Norpz/Baka/robotont-electronics-mainboard-devel-veiko/3dmodels/MR30PW-M v2.step

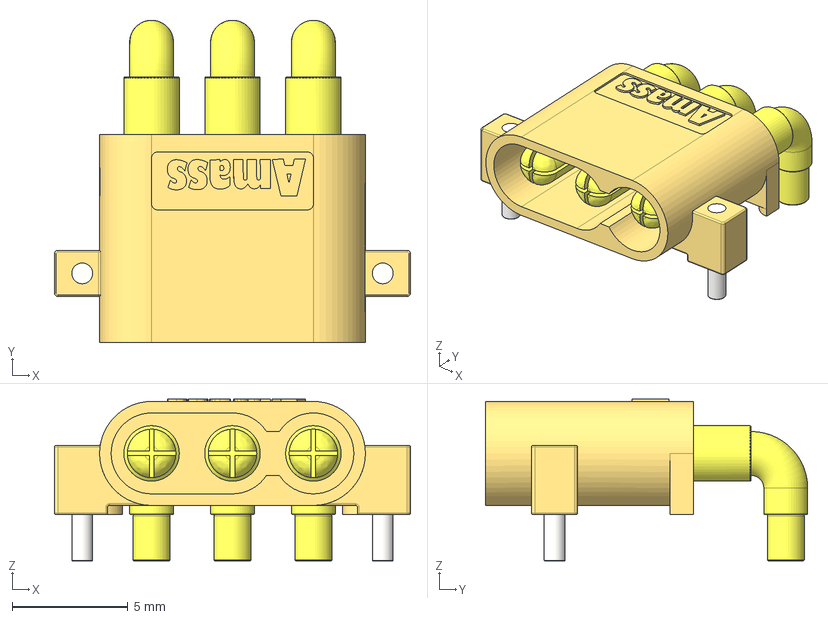
[picture p1: CAD file, 2023-09-22]
robotont-electronics-mainboard-devel-veiko/3dmodels/MR30PW-M v2.step
15.4 x 13.9 x 7.00 mm
PCB Pins
Pin 2 x 3
