Norpz/Baka/robotont-electronics-mainboard-devel-veiko/3dmodels/USB_C_Receptacle_USB2.0.STEP

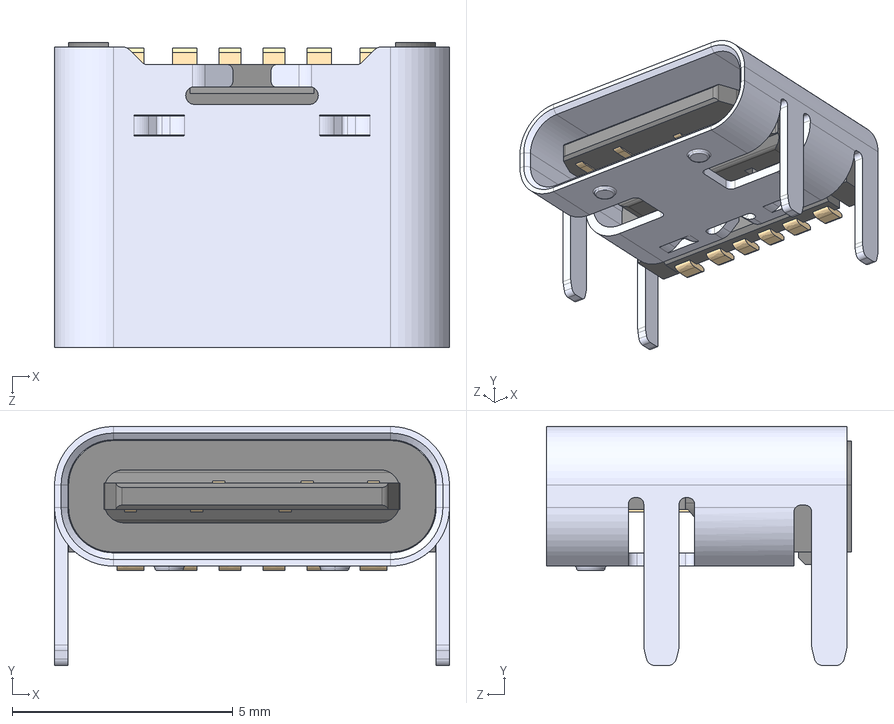
[picture p3: CAD file, 2023-09-22]
robotont-electronics-mainboard-devel-veiko/3dmodels/USB_C_Receptacle_USB2.0.STEP
8.94 x 5.41 x 6.90 mm
