Norpz/Baka/robotont-electronics-mainboard-devel-veiko/3dmodels/IND-FXL1040 v5.step

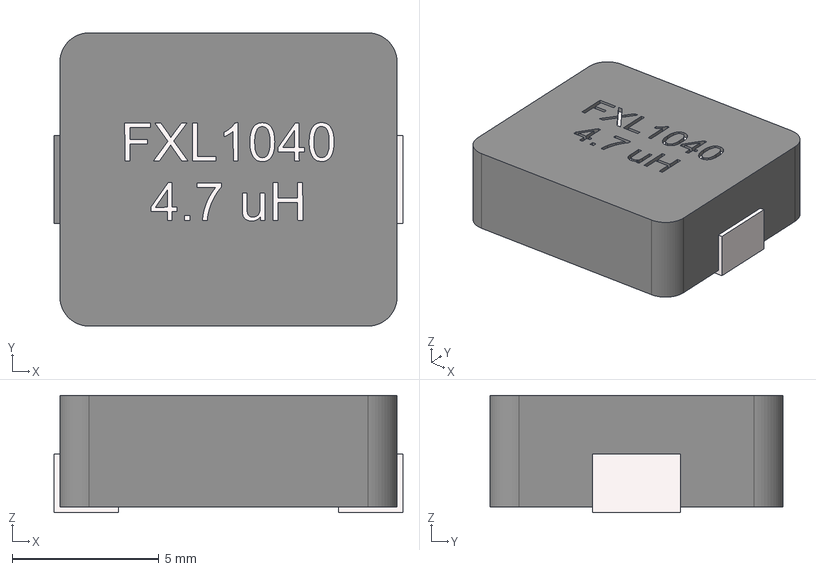
[picture p4: CAD file, 2023-09-22]
robotont-electronics-mainboard-devel-veiko/3dmodels/IND-FXL1040 v5.step
11.9 x 10.0 x 4.00 mm
