Norpz/Baka/robotont-electronics-mainboard-devel-veiko/3dmodels/DIODE-SOD-128.step

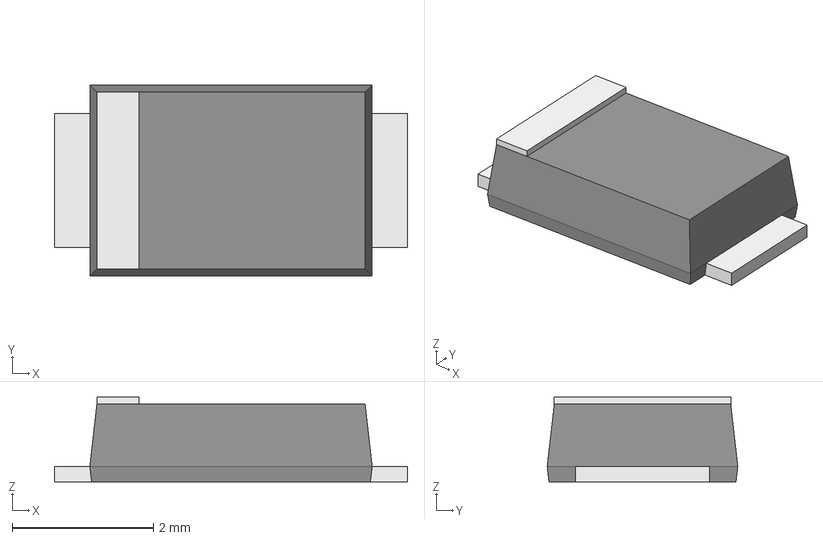
[picture p5: CAD file, 2023-09-22]
robotont-electronics-mainboard-devel-veiko/3dmodels/DIODE-SOD-128.step
5.00 x 2.70 x 1.20 mm
