Norpz/Baka/robotont-electronics-mainboard-devel-veiko/3dmodels/Diode_powerdi5.STEP

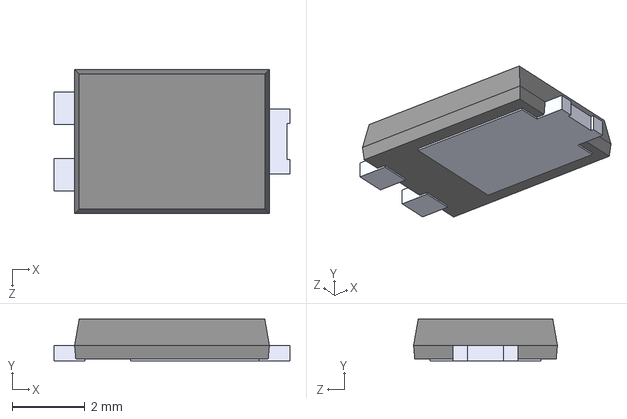
[picture p6: CAD file, 2023-09-22]
robotont-electronics-mainboard-devel-veiko/3dmodels/Diode_powerdi5.STEP
6.50 x 1.15 x 3.97 mm
