Norpz/Baka/robotont-electronics-mainboard-devel-veiko/3dmodels/SI7149ADP-T1-GE3.STEP

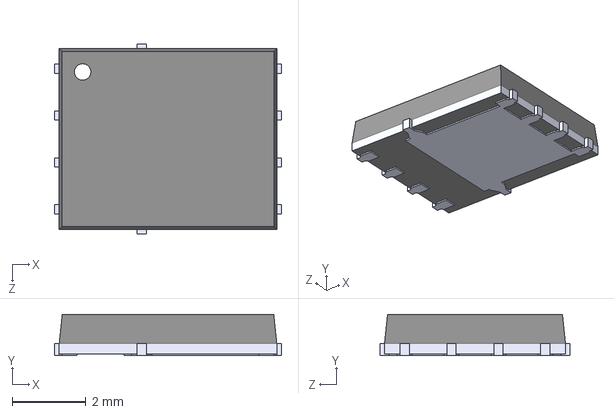
[picture p7: CAD file, 2023-09-22]
robotont-electronics-mainboard-devel-veiko/3dmodels/SI7149ADP-T1-GE3.STEP
6.15 x 1.12 x 5.16 mm
