Norpz/Baka/robotont-electronics-mainboard-devel-veiko/3dmodels/buzzer_smd_5x5mm.step

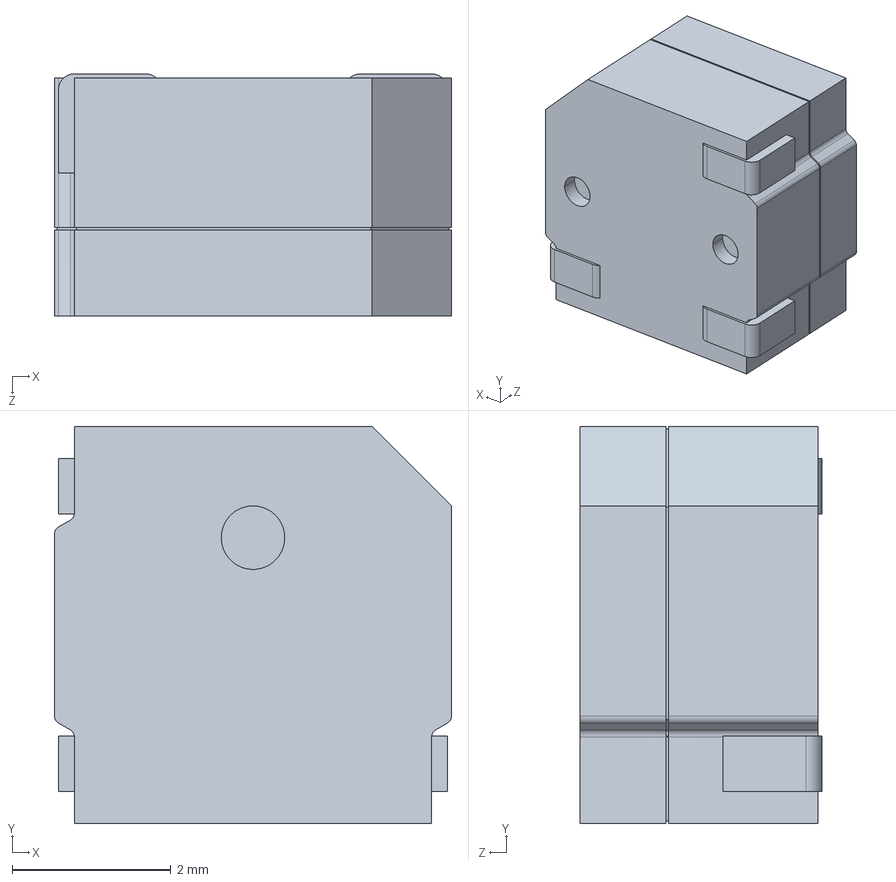
[picture p8: CAD file, 2023-09-22]
robotont-electronics-mainboard-devel-veiko/3dmodels/buzzer_smd_5x5mm.step
5.00 x 5.00 x 3.05 mm
