Norpz/Baka/robotont-electronics-mainboard-devel-veiko/3dmodels/IND-JSHC0650-5R6M v3.step

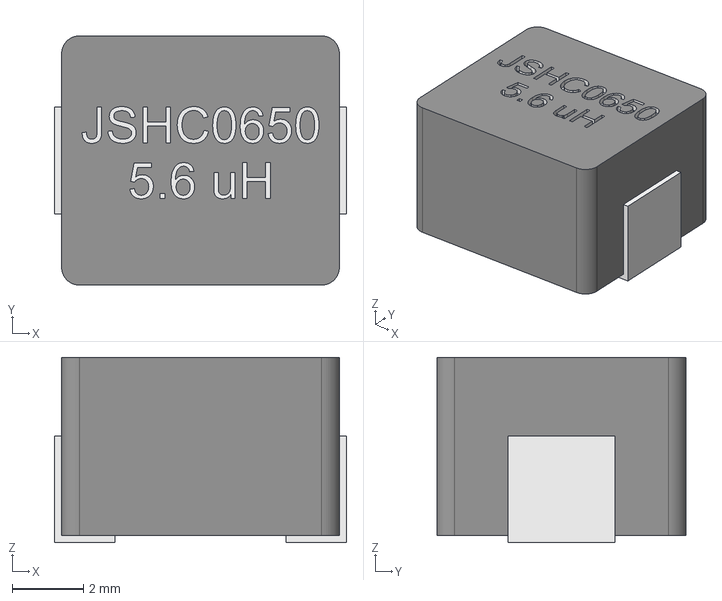
[picture p9: CAD file, 2023-09-22]
robotont-electronics-mainboard-devel-veiko/3dmodels/IND-JSHC0650-5R6M v3.step
8.20 x 7.00 x 5.20 mm
