Norpz/Baka/robotont-electronics-mainboard-devel-veiko/3dmodels/SMD WS2812B Mini.step

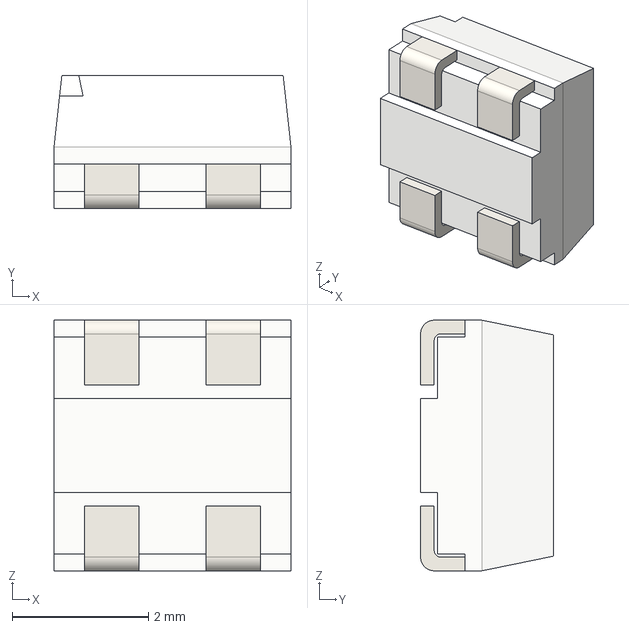
[picture p10: CAD file, 2023-09-22]
robotont-electronics-mainboard-devel-veiko/3dmodels/SMD WS2812B Mini.step
3.48 x 1.95 x 3.68 mm
