Norpz/Baka/robotont-electronics-mainboard-devel-veiko/3dmodels/RUEF300.stp

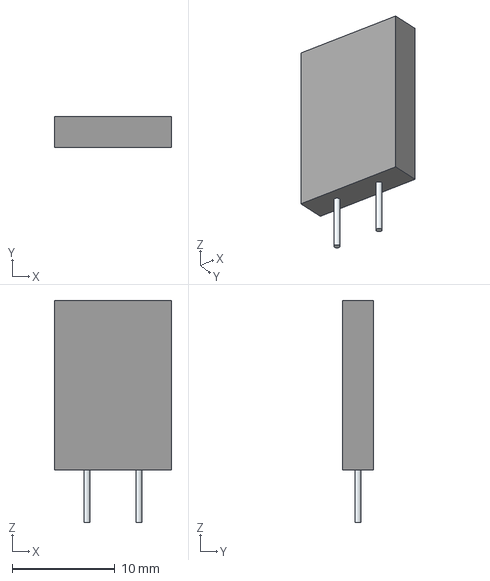
[picture p11: CAD file, 2023-09-22]
robotont-electronics-mainboard-devel-veiko/3dmodels/RUEF300.stp
11.4 x 3.00 x 21.6 mm
Leads x 2
