Norpz/Baka/robotont-electronics-mainboard-devel-veiko/3dmodels/IND_17.5x17.15x7.stp

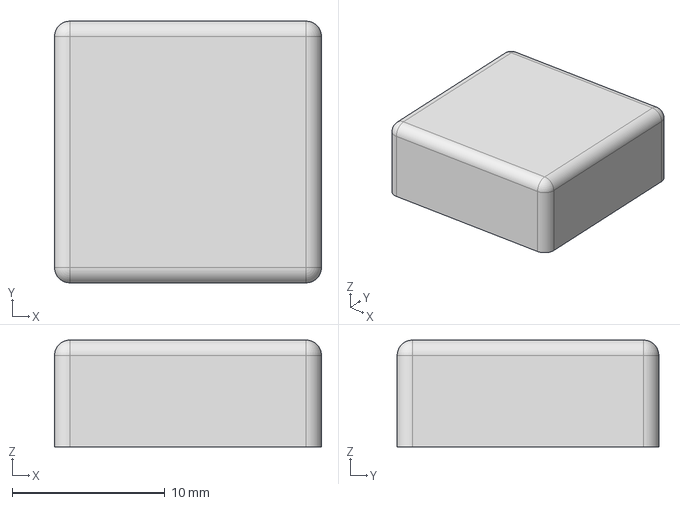
[picture p12: CAD file, 2023-09-22]
robotont-electronics-mainboard-devel-veiko/3dmodels/IND_17.5x17.15x7.stp
17.5 x 17.1 x 7.00 mm
