Norpz/Baka/robotont-electronics-mainboard-devel-veiko/3dmodels/43045-0212--3DModel-STEP-390490.STEP

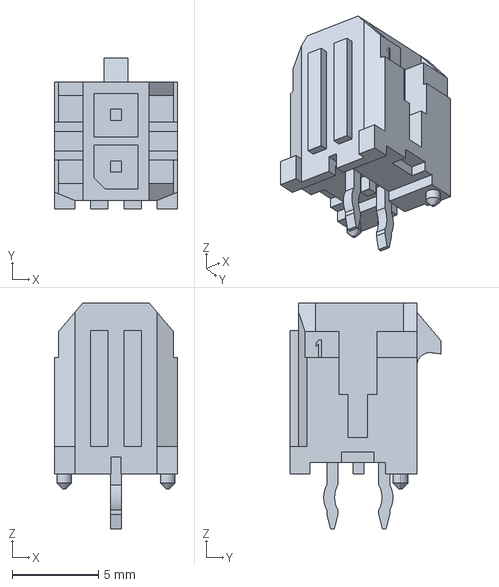
[picture p13: CAD file, 2023-09-22]
robotont-electronics-mainboard-devel-veiko/3dmodels/43045-0212--3DModel-STEP-390490.STEP
7.15 x 8.77 x 13.1 mm
