Norpz/Baka/robotont-electronics-mainboard-devel-veiko/3dmodels/43045-0612--3DModel-STEP-269445.STEP

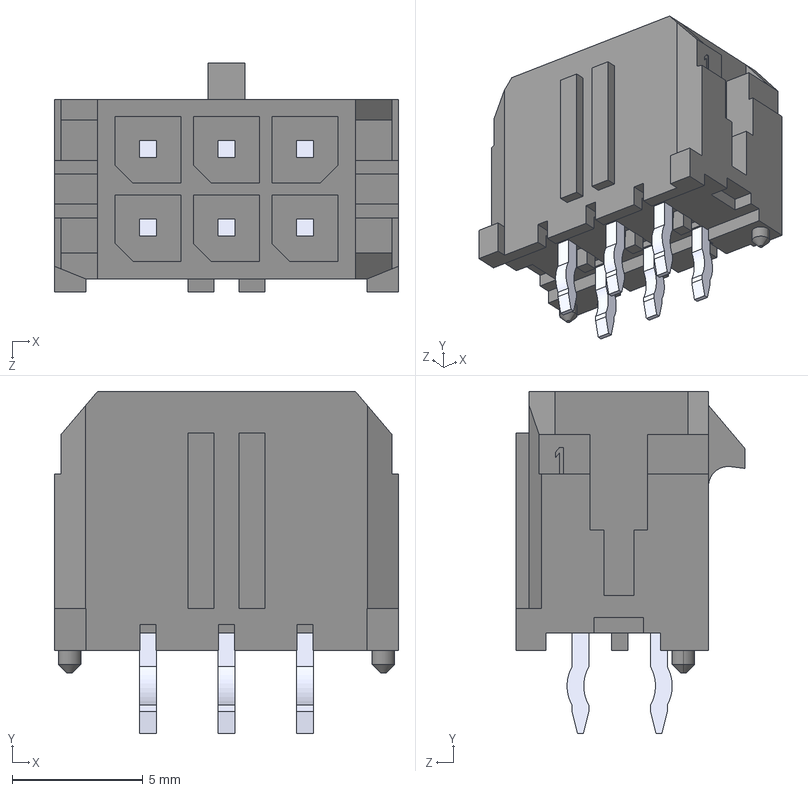
[picture p14: CAD file, 2023-09-22]
robotont-electronics-mainboard-devel-veiko/3dmodels/43045-0612--3DModel-STEP-269445.STEP
13.2 x 13.1 x 8.77 mm
