Norpz/Baka/robotont-electronics-mainboard-devel-veiko/dc_dc_3V3_pm.kicad_sch

## KiCad design robotont-electronics-mainboard-devel-veiko/dc_dc_3V3_pm.kicad_sch (2023-09-22)

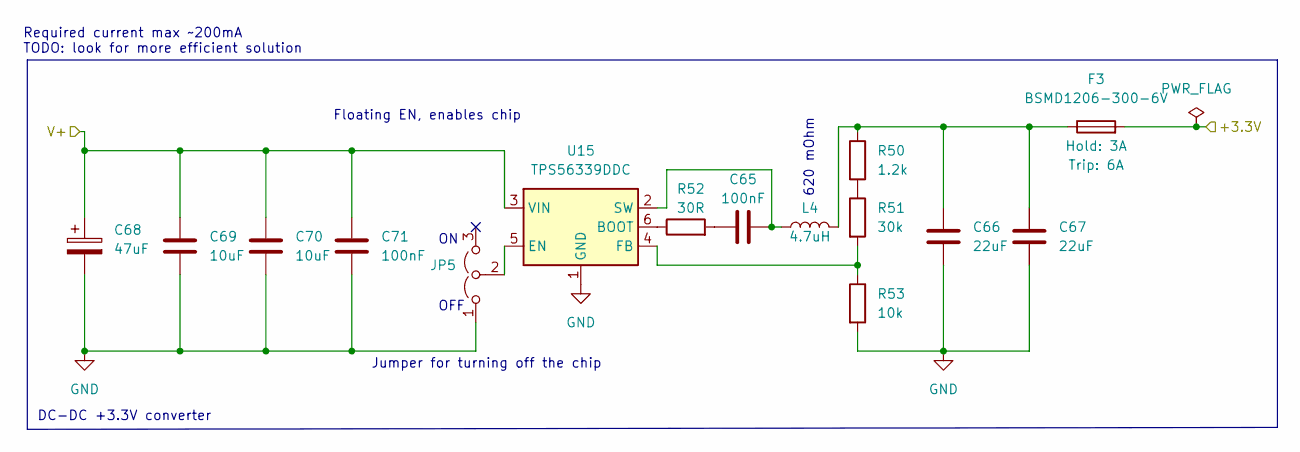
[picture p15: schematic dc_dc_3V3_pm.kicad_sch]

Parts:
C65, C71: 100nF; C_0805_2012Metric; LCSC Part C49678
C66, C67: 22uF; C_1206_3216Metric; LCSC Part C12891
C68: 47uF; C_1206_3216Metric; LCSC Part C403725
C69, C70: 10uF; C_1206_3216Metric; LCSC Part C13585
F3: BSMD1206-300-6V; Fuse_1206_3216Metric_Pad1.42x1.75mm_HandSolder; LCSC Part C883136
JP5: PinHeader_1x03_P2.54mm_Vertical
L4: 4.7uH; IND-FXL1040-4R7-M; LCSC Part C167230
R50: 1.2k; R_0603_1608Metric; LCSC Part C22765
R51: 30k; R_0603_1608Metric; LCSC Part C22984
R52: 30R; R_0603_1608Metric; LCSC Part C23140
R53: 10k; R_0603_1608Metric; LCSC Part C25804
U15: TPS56339DDC; TSOT-23-6; LCSC Part C2071106

Connections:
+3.3V: F3.2
GND: C66.2, C67.2, C68.2, C69.2, C70.2, C71.2, JP5.1 (A), R53.2, U15.1 (GND)
unnamed: C65.1, R52.2
unnamed: C65.2, L4.1, U15.2 (SW)
unnamed: C66.1, C67.1, F3.1, L4.2, R50.1
unnamed: JP5.2 (C), U15.5 (EN)
unnamed: R50.2, R51.1
unnamed: R51.2, R53.1, U15.4 (FB)
unnamed: R52.1, U15.6 (BOOT)
V+: C68.1, C69.1, C70.1, C71.1, U15.3 (VIN)

Notes on the sheet:
OFF
Floating EN, enables chip
620 mOhm
Jumper for turning off the chip
Required current max ~200mA TODO: look for more efficient solution
DC-DC +3.3V converter
