Norpz/Baka/robotont-electronics-mainboard-devel-veiko/dc_dc_12v_motors.kicad_sch

## KiCad design robotont-electronics-mainboard-devel-veiko/dc_dc_12v_motors.kicad_sch (2023-09-22)

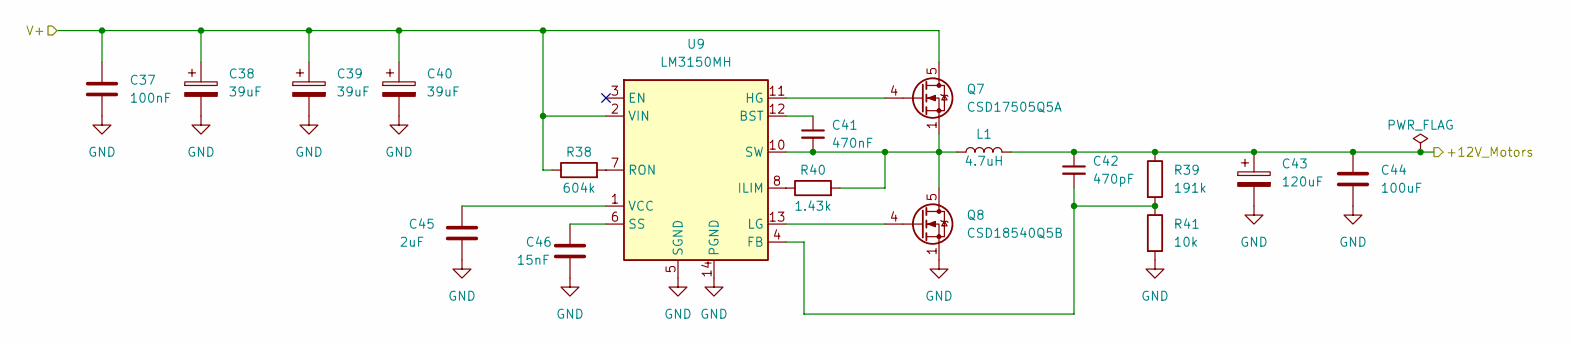
[picture p16: schematic dc_dc_12v_motors.kicad_sch]

Parts:
C37: 100nF; C_0805_2012Metric; LCSC Part C49678
C38, C39, C40: 39uF; CAP-SMD_BD8.0-L8.3-W8.3-LS9.0-FD_35SVPF39M; LCSC Part C189474
C41: 470nF; C_0805_2012Metric; LCSC Part C13967
C42: 470pF; C_0805_2012Metric; LCSC Part C1743
C43: 120uF; CAP-SMD_BD10.0-L10.3-W10.3-FD_EEHZC1E331P; LCSC Part C128514
C44: 100uF; C_1210_3225Metric; LCSC Part C90143
C45: 2uF; C_0805_2012Metric; LCSC Part C49217
C46: 15nF; C_0603_1608Metric; LCSC Part C1596
L1: 4.7uH; IND-SMD_L17.5-W17.5; LCSC Part C357285
Q7: CSD17505Q5A; TDSON-8-1; LCSC Part C553150
Q8: CSD18540Q5B; TDSON-8-1; LCSC Part C86513
R38: 604k; R_0805_2012Metric_Pad1.20x1.40mm_HandSolder; LCSC Part C483204
R39: 191k; R_0805_2012Metric_Pad1.20x1.40mm_HandSolder; LCSC Part C228358
R40: 1.43k; R_0805_2012Metric_Pad1.20x1.40mm_HandSolder; LCSC Part C482962
R41: 10k; R_0805_2012Metric_Pad1.20x1.40mm_HandSolder; LCSC Part C84376
U9: LM3150MH; HTSSOP-14-1EP_4.4x5mm_P0.65mm_EP3.4x5mm_Mask3x3.1mm; LCSC Part C48112

Connections:
+12V_Motors: C42.1, C43.1, C44.1, L1.2, R39.1
GND: C37.2, C38.2, C39.2, C40.2, C43.2, C44.2, C45.2, C46.2, Q8.1 (S), Q8.2 (S), Q8.3 (S), R41.2, U9.5 (SGND), U9.9 (SGND), U9.14 (PGND), U9.15 (SGND)
unnamed: C41.1, U9.12 (BST)
unnamed: C41.2, L1.1, Q7.1 (S), Q7.2 (S), Q7.3 (S), Q8.5 (D), R40.2, U9.10 (SW)
unnamed: C42.2, R39.2, R41.1, U9.4 (FB)
unnamed: C45.1, U9.1 (VCC)
unnamed: C46.1, U9.6 (SS)
unnamed: Q7.4 (G), U9.11 (HG)
unnamed: Q8.4 (G), U9.13 (LG)
unnamed: R38.2, U9.7 (RON)
unnamed: R40.1, U9.8 (ILIM)
V+: C37.1, C38.1, C39.1, C40.1, Q7.5 (D), R38.1, U9.2 (VIN)
