Norpz/Baka/robotont-electronics-mainboard-devel-veiko/dc_dc_ext.kicad_sch

## KiCad design robotont-electronics-mainboard-devel-veiko/dc_dc_ext.kicad_sch (2023-09-22)

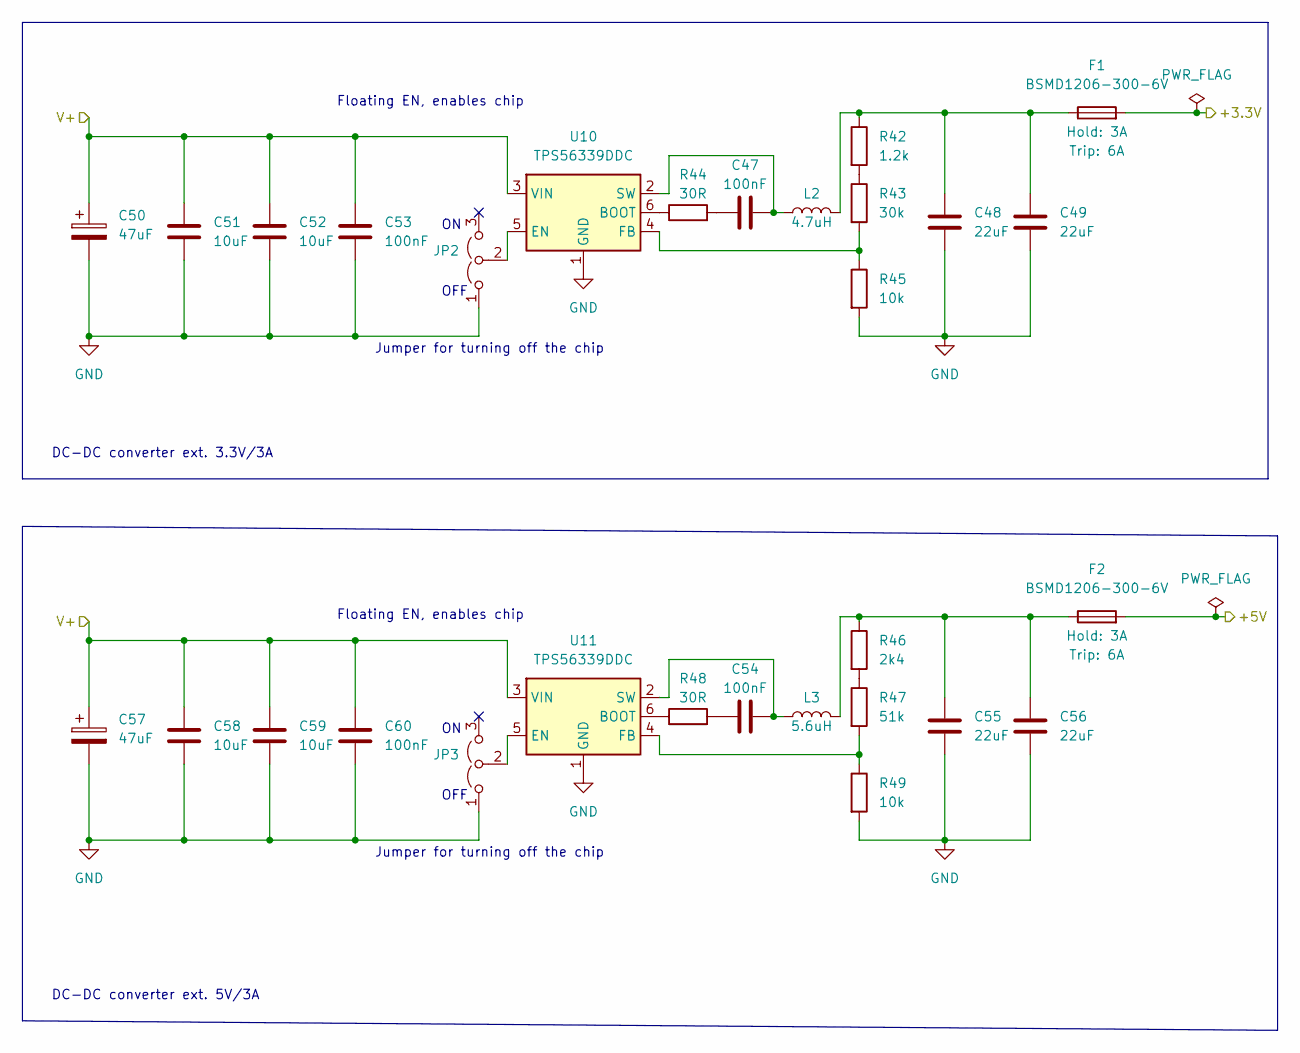
[picture p17: schematic dc_dc_ext.kicad_sch]

Parts:
C47, C53, C54, C60: 100nF; C_0805_2012Metric; LCSC Part C49678
C48, C49, C55, C56: 22uF; C_1206_3216Metric; LCSC Part C12891
C50, C57: 47uF; C_1206_3216Metric; LCSC Part C403725
C51, C52, C58, C59: 10uF; C_1206_3216Metric; LCSC Part C13585
F1, F2: BSMD1206-300-6V; Fuse_1206_3216Metric_Pad1.42x1.75mm_HandSolder; LCSC Part C883136
JP2, JP3: PinHeader_1x03_P2.54mm_Vertical
L2: 4.7uH; IND-FXL1040-4R7-M; LCSC Part C167230
L3: 5.6uH; IND-JSHC0650-5R6M; LCSC Part C386869
R42: 1.2k; R_0603_1608Metric; LCSC Part C22765
R43: 30k; R_0603_1608Metric; LCSC Part C22984
R44, R48: 30R; R_0603_1608Metric; LCSC Part C23140
R45, R49: 10k; R_0603_1608Metric; LCSC Part C25804
R46: 2k4; R_0603_1608Metric; LCSC Part C22940
R47: 51k; R_0603_1608Metric; LCSC Part C23196
U10, U11: TPS56339DDC; TSOT-23-6; LCSC Part C2071106

Connections:
+3.3V: F1.2
+5V: F2.2
GND: C48.2, C49.2, C50.2, C51.2, C52.2, C53.2, C55.2, C56.2, C57.2, C58.2, C59.2, C60.2, JP2.1 (A), JP3.1 (A), R45.2, R49.2, U10.1 (GND), U11.1 (GND)
unnamed: C47.1, R44.2
unnamed: C47.2, L2.1, U10.2 (SW)
unnamed: C48.1, C49.1, F1.1, L2.2, R42.1
unnamed: C54.1, R48.2
unnamed: C54.2, L3.1, U11.2 (SW)
unnamed: C55.1, C56.1, F2.1, L3.2, R46.1
unnamed: JP2.2 (C), U10.5 (EN)
unnamed: JP3.2 (C), U11.5 (EN)
unnamed: R42.2, R43.1
unnamed: R43.2, R45.1, U10.4 (FB)
unnamed: R44.1, U10.6 (BOOT)
unnamed: R46.2, R47.1
unnamed: R47.2, R49.1, U11.4 (FB)
unnamed: R48.1, U11.6 (BOOT)
V+: C50.1, C51.1, C52.1, C53.1, C57.1, C58.1, C59.1, C60.1, U10.3 (VIN), U11.3 (VIN)

Notes on the sheet:
OFF
Jumper for turning off the chip
DC-DC converter ext. 5V/3A
Floating EN, enables chip
DC-DC converter ext. 3.3V/3A
