Norpz/Baka/robotont-electronics-mainboard-devel-veiko/ext_devices.kicad_sch

## KiCad design robotont-electronics-mainboard-devel-veiko/ext_devices.kicad_sch (2023-09-22)

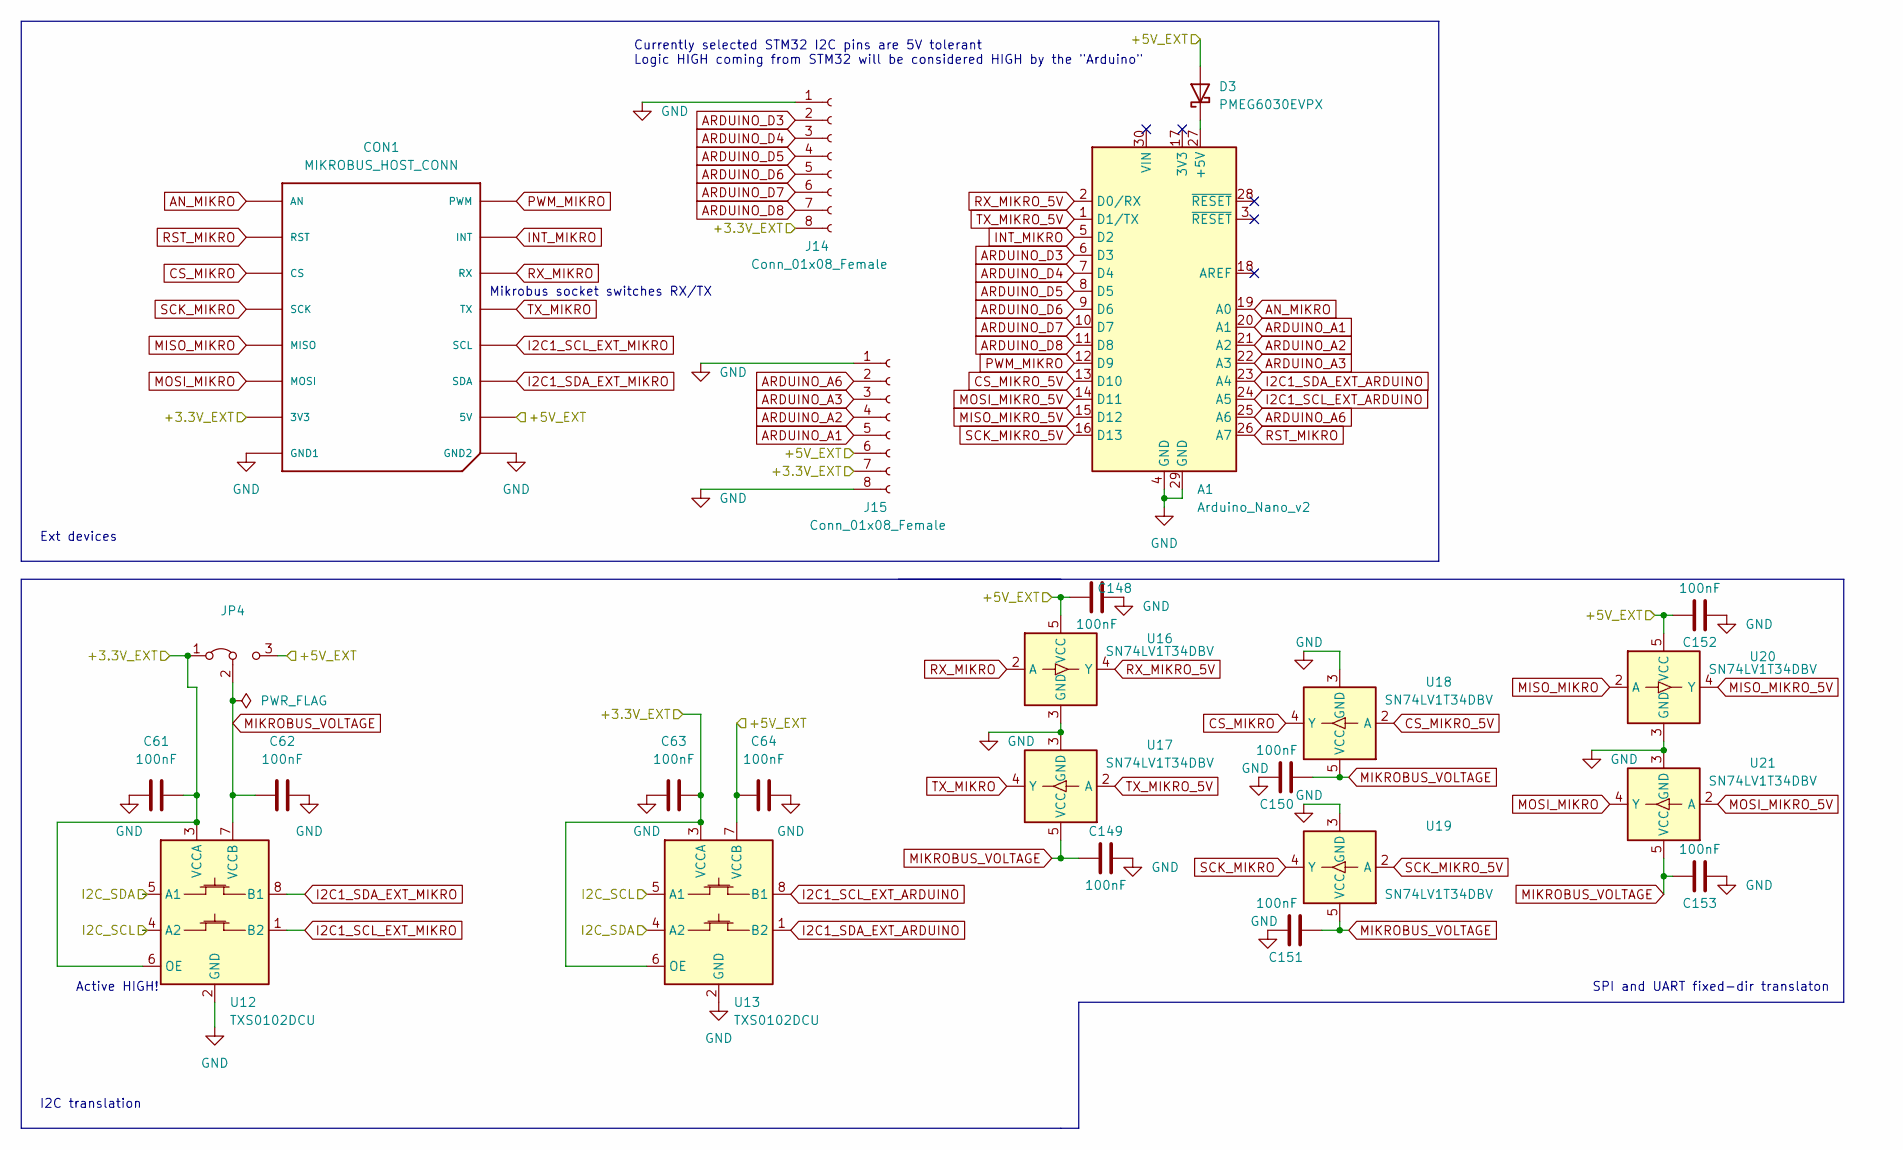
[picture p18: schematic ext_devices.kicad_sch]

Parts:
A1: Arduino_Nano_v2; Arduino_Nano
C61, C62, C63, C64: 100nF; C_0805_2012Metric; LCSC Part C49678
C148, C149, C150, C151, C152, C153: 100nF; C_0402_1005Metric; LCSC Part C307331
CON1: MIKROBUS_HOST_CONN; MIKROBUS_HOST_CONN_M
D3: PMEG6030EVPX; D_SOD-128; LCSC Part C489223
J14, J15: Conn_01x08_Female; PinSocket_1x08_P2.54mm_Vertical
JP4: PinHeader_1x03_P2.54mm_Vertical
U12, U13: TXS0102DCU; VSSOP-8_2.3x2mm_P0.5mm; LCSC Part C53434
U16, U17, U18, U19, U20, U21: SN74LV1T34DBV; SOT-23-5; LCSC Part C100024

Connections:
+3.3V_EXT: C61.2, C63.2, CON1.P7 (3V3), J14.8, J15.7, JP4.1 (A), U12.3 (VCCA), U12.6 (OE), U13.3 (VCCA), U13.6 (OE)
+5V_EXT: C64.1, C148.1, C152.1, CON1.P10 (5V), D3.2 (A), J15.6, JP4.3 (B), U13.7 (VCCB), U16.5 (VCC), U20.5 (VCC)
AN_MIKRO: A1.19 (A0), CON1.P1 (AN)
ARDUINO_A1: A1.20 (A1), J15.5
ARDUINO_A2: A1.21 (A2), J15.4
ARDUINO_A3: A1.22 (A3), J15.3
ARDUINO_A6: A1.25 (A6), J15.2
ARDUINO_D3: A1.6 (D3), J14.2
ARDUINO_D4: A1.7 (D4), J14.3
ARDUINO_D5: A1.8 (D5), J14.4
ARDUINO_D6: A1.9 (D6), J14.5
ARDUINO_D7: A1.10 (D7), J14.6
ARDUINO_D8: A1.11 (D8), J14.7
CS_MIKRO: CON1.P3 (CS), U18.4 (Y)
CS_MIKRO_5V: A1.13 (D10), U18.2 (A)
GND: A1.4 (GND), A1.29 (GND), C61.1, C62.2, C63.1, C64.2, C148.2, C149.2, C150.1, C151.1, C152.2, C153.2, CON1.P8 (GND1), CON1.P9 (GND2), J14.1, J15.1, J15.8, U12.2 (GND), U13.2 (GND), U16.3 (GND), U17.3 (GND), U18.3 (GND), U19.3 (GND), U20.3 (GND), U21.3 (GND)
I2C1_SCL_EXT_ARDUINO: A1.24 (A5), U13.8 (B1)
I2C1_SCL_EXT_MIKRO: CON1.P12 (SCL), U12.1 (B2)
I2C1_SDA_EXT_ARDUINO: A1.23 (A4), U13.1 (B2)
I2C1_SDA_EXT_MIKRO: CON1.P11 (SDA), U12.8 (B1)
I2C_SCL: U12.4 (A2), U13.5 (A1)
I2C_SDA: U12.5 (A1), U13.4 (A2)
INT_MIKRO: A1.5 (D2), CON1.P15 (INT)
MIKROBUS_VOLTAGE: C62.1, C149.1, C150.2, C151.2, C153.1, JP4.2 (C), U12.7 (VCCB), U17.5 (VCC), U18.5 (VCC), U19.5 (VCC), U21.5 (VCC)
MISO_MIKRO: CON1.P5 (MISO), U20.2 (A)
MISO_MIKRO_5V: A1.15 (D12), U20.4 (Y)
MOSI_MIKRO: CON1.P6 (MOSI), U21.4 (Y)
MOSI_MIKRO_5V: A1.14 (D11), U21.2 (A)
unnamed: A1.27 (+5V), D3.1 (K)
PWM_MIKRO: A1.12 (D9), CON1.P16 (PWM)
RST_MIKRO: A1.26 (A7), CON1.P2 (RST)
RX_MIKRO: CON1.P14 (RX), U16.2 (A)
RX_MIKRO_5V: A1.2 (D0/RX), U16.4 (Y)
SCK_MIKRO: CON1.P4 (SCK), U19.4 (Y)
SCK_MIKRO_5V: A1.16 (D13), U19.2 (A)
TX_MIKRO: CON1.P13 (TX), U17.4 (Y)
TX_MIKRO_5V: A1.1 (D1/TX), U17.2 (A)

Notes on the sheet:
Mikrobus socket switches RX/TX
SPI and UART fixed-dir translaton
I2C translation
Active HIGH!
Currently selected STM32 I2C pins are 5V tolerant Logic HIGH coming from STM32 will be considered HIGH by the "Arduino"
Ext devices
