Norpz/Baka/robotont-electronics-mainboard-devel-veiko/high_side_switch.kicad_sch

## KiCad design robotont-electronics-mainboard-devel-veiko/high_side_switch.kicad_sch (2023-09-22)

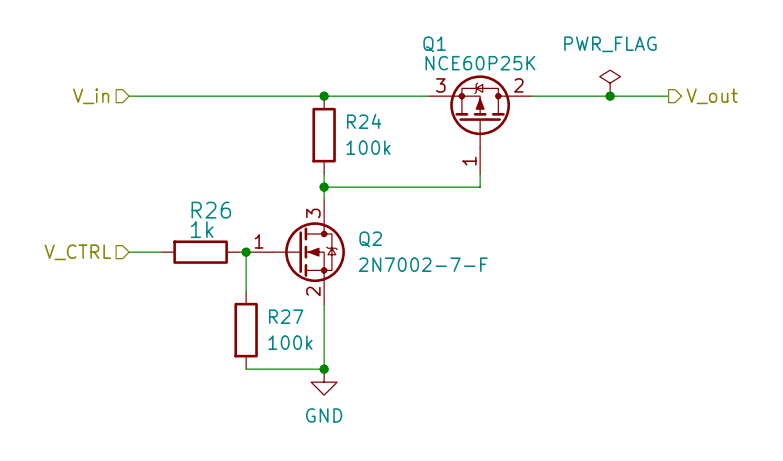
[picture p19: schematic high_side_switch.kicad_sch]

Parts:
Q1: NCE60P25K; TO-252-2; LCSC Part C130105
Q2: 2N7002-7-F; SOT-23; LCSC Part C53550
R24, R27: 100k; R_0603_1608Metric; LCSC Part C25803
R26: 1k; R_0603_1608Metric; LCSC Part C21190

Connections:
GND: Q2.2 (S), R27.2
unnamed: Q1.1 (G), Q2.3 (D), R24.2
unnamed: Q2.1 (G), R26.1, R27.1
V_CTRL: R26.2
V_in: Q1.3 (S), R24.1
V_out: Q1.2 (D)
