Norpz/Baka/robotont-electronics-mainboard-devel-veiko/mainboard.kicad_sch

## KiCad design robotont-electronics-mainboard-devel-veiko/mainboard.kicad_sch (2023-09-22)

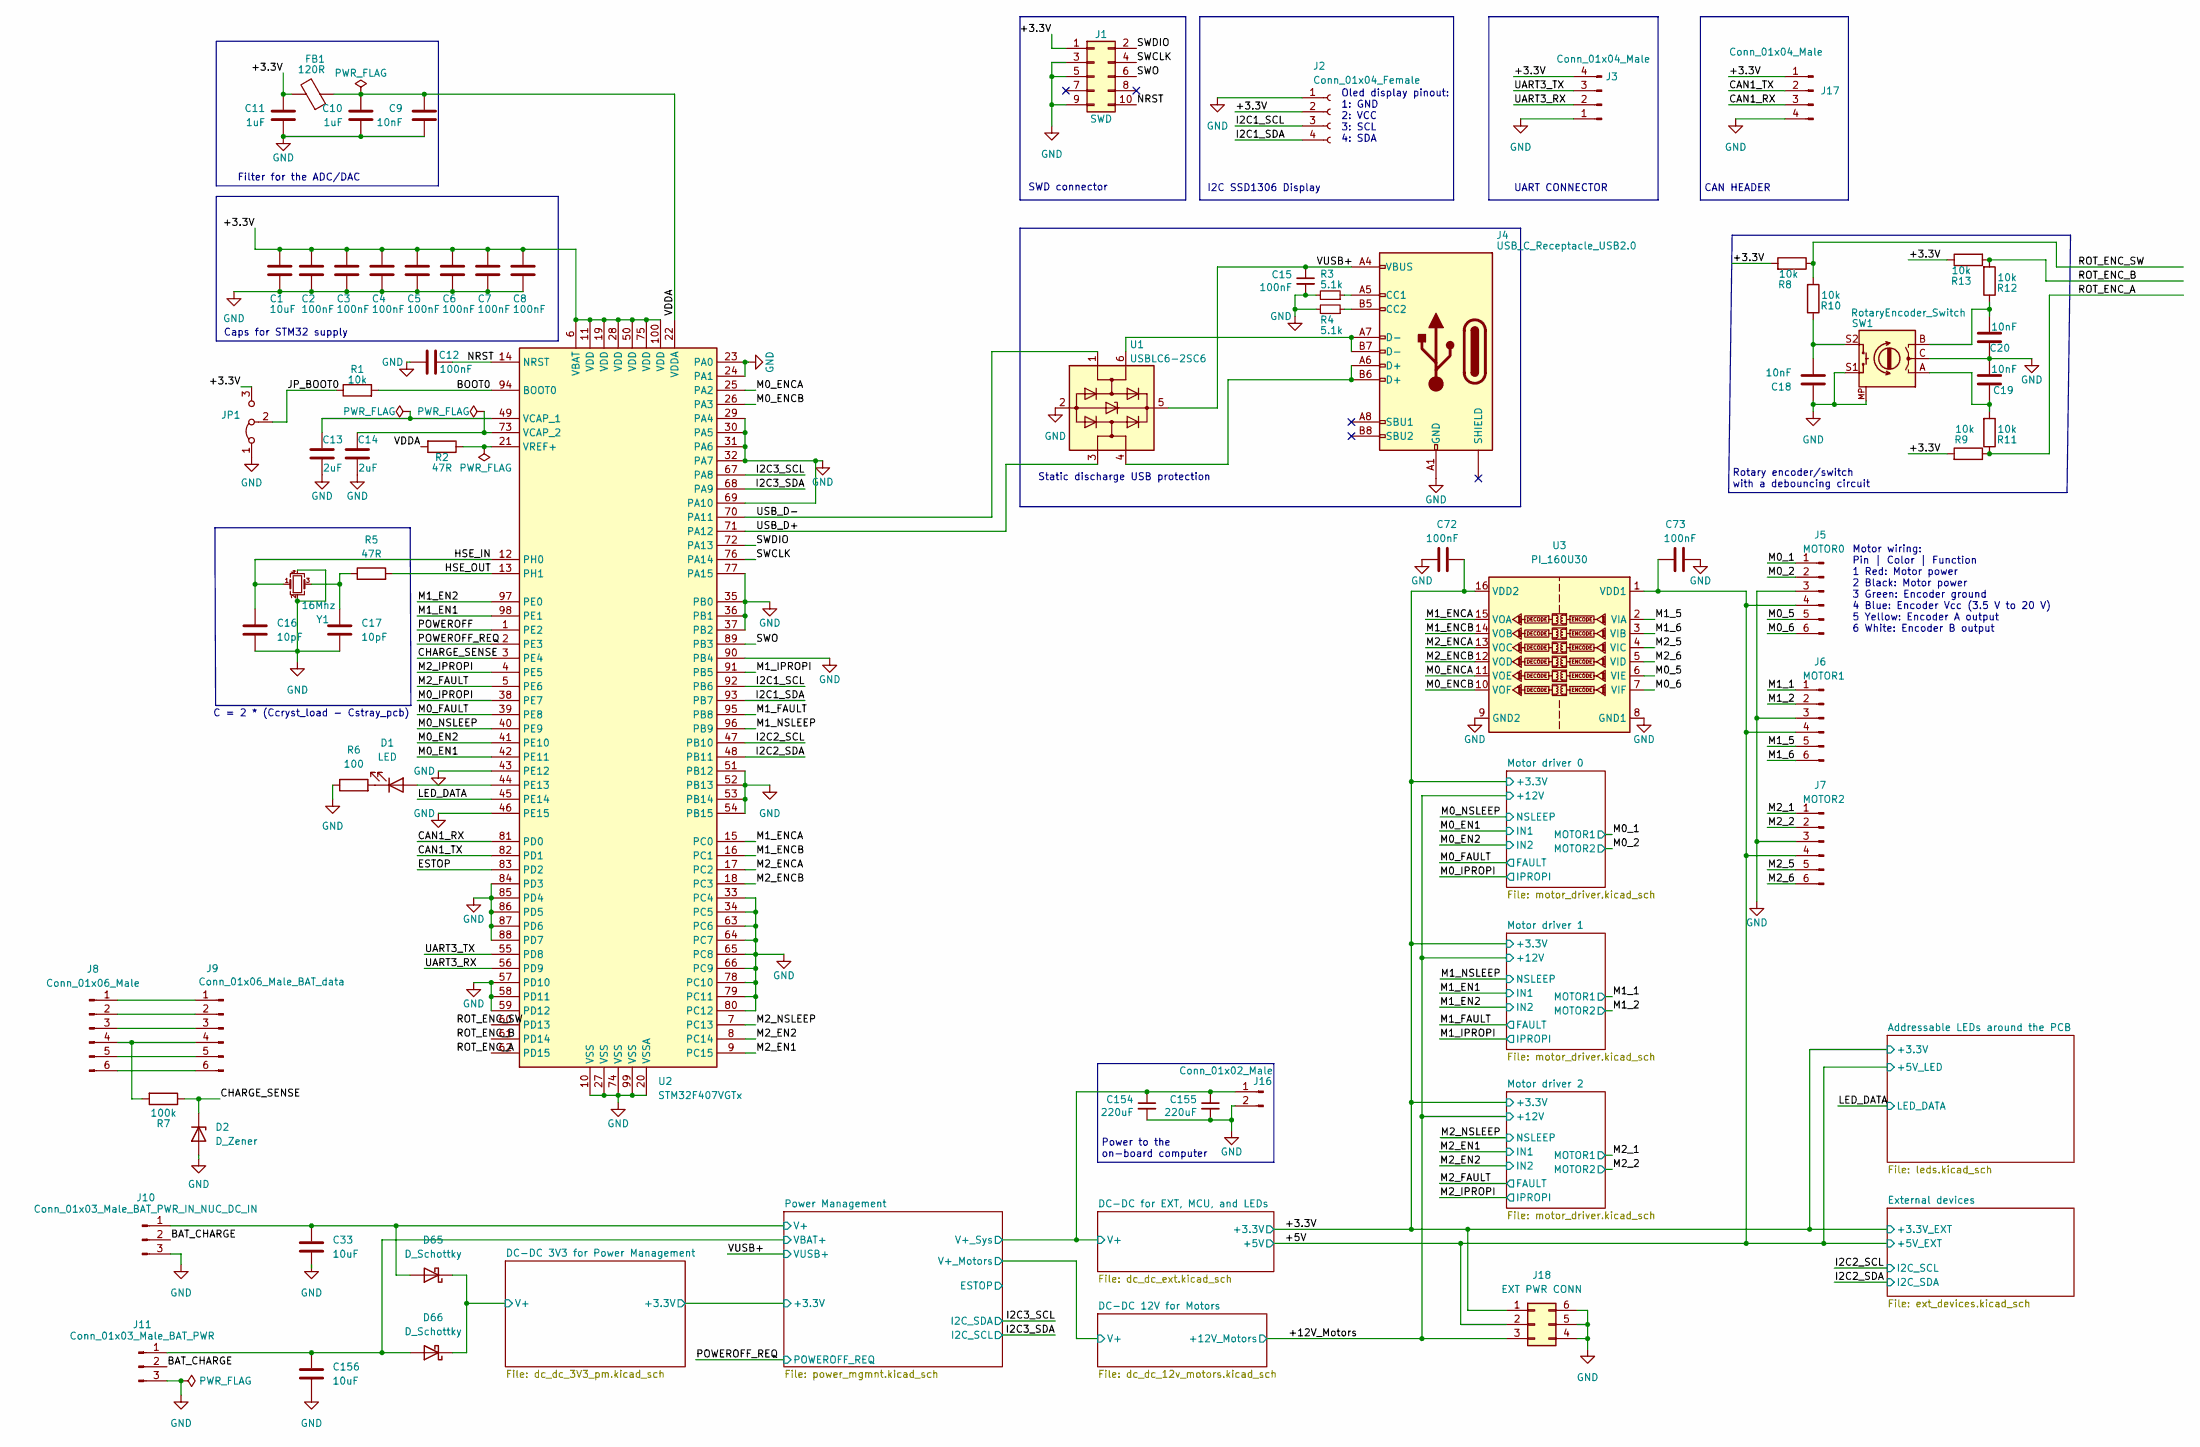
[picture p21: schematic mainboard.kicad_sch]

Parts:
C1, C33, C156: 10uF; C_1206_3216Metric; LCSC Part C13585
C2, C3, C4, C5, C6, C7, C8, C12, C15, C72, C73: 100nF; C_0402_1005Metric; LCSC Part C307331
C9, C18, C19, C20: 10nF; C_0402_1005Metric; LCSC Part C1546
C10, C11: 1uF; C_0603_1608Metric; LCSC Part C15849
C13, C14: 2uF; C_0805_2012Metric; LCSC Part C49217
C16, C17: 10pF; C_0603_1608Metric; LCSC Part C1634
C154, C155: 220uF; CP_Elec_8x10.5; LCSC Part C251000
D1: LED; LED_0603_1608Metric; LCSC Part C72043
D2: D_Zener; D_MiniMELF; LCSC Part C8056
D65, D66: D_Schottky; D_SMA; LCSC Part C92506
FB1: 120R; R_0805_2012Metric; LCSC Part C1015
J1: SWD; PinHeader_2x05_P2.54mm_Horizontal
J2: Conn_01x04_Female; SSD1306_0.96_Oled
J3, J17: Conn_01x04_Male; PinHeader_1x04_P2.54mm_Horizontal
J4: USB_C_Receptacle_USB2.0; USB_C_Receptacle_HRO_TYPE-C-31-M-12; LCSC Part C709357
J5, J6, J7: PinHeader_1x06; PinHeader_1x06_P2.54mm_Horizontal
J8: Conn_01x06_Male; JST_PH_S6B-PH-K_1x06_P2.00mm_Horizontal
J9: Conn_01x06_Male_BAT_data; JST_PH_S6B-PH-K_1x06_P2.00mm_Horizontal
J10: Conn_01x03_Male_BAT_PWR_IN_NUC_DC_IN; AMASS_MR30PW-M_1x03_P3.50mm_Horizontal
J11: Conn_01x03_Male_BAT_PWR; AMASS_MR30PW-M_1x03_P3.50mm_Horizontal
J16: Conn_01x02_Male; Molex_Micro-Fit_3.0_43045-0212_2x01_P3.00mm_Vertical
J18: EXT PWR CONN; Molex_Micro-Fit_3.0_43045-0612_2x03_P3.00mm_Vertical
JP1: PinHeader_1x03_P2.54mm_Vertical
R1, R8, R9, R10, R11, R12, R13: 10k; R_0603_1608Metric; LCSC Part C25804
R2, R5: 47R; R_0603_1608Metric; LCSC Part C23182
R3, R4: 5.1k; R_0603_1608Metric; LCSC Part C23186
R6: 100; R_0603_1608Metric; LCSC Part C22775
R7: 100k; R_0603_1608Metric; LCSC Part C25803
SW1: RotaryEncoder_Switch; RotaryEncoder_Alps_EC11E-Switch_Vertical_H20mm
U1: USBLC6-2SC6; SOT-23-6; LCSC Part C7519
U2: STM32F407VGTx; LQFP-100_14x14mm_P0.5mm; LCSC Part C919362
U3: PI_160U30; SOIC-16_3.9x9.9mm_P1.27mm; LCSC Part C471608
Y1: 16Mhz; Crystal_SMD_3225-4Pin_3.2x2.5mm; LCSC Part C13738

Connections:
+3.3V: C1.1, C2.1, C3.1, C4.1, C5.1, C6.1, C7.1, C8.1, C11.1, C72.1, FB1.2, J1.1, J2.2, J3.4, J17.1, J18.1, JP1.3 (B), R8.2, R9.2, R13.1, U2.6 (VBAT), U2.11 (VDD), U2.19 (VDD), U2.28 (VDD), U2.50 (VDD), U2.75 (VDD), U2.100 (VDD), U3.16 (VDD2)
+5V: C73.1, J5.4, J6.4, J7.4, J18.2, U3.1 (VDD1)
+12V_Motors: J18.3
BAT_CHARGE: J10.2, J11.2
BOOT0: R1.2, U2.94 (BOOT0)
CAN1_RX: J17.3, U2.81 (PD0)
CAN1_TX: J17.2, U2.82 (PD1)
CHARGE_SENSE: D2.1 (K), R7.1, U2.3 (PE4)
ESTOP: U2.83 (PD2)
GND: C1.2, C2.2, C3.2, C4.2, C5.2, C6.2, C7.2, C8.2, C9.2, C10.2, C11.2, C12.2, C13.1, C14.1, C15.2, C16.2, C17.2, C18.1, C19.2, C20.1, C33.2, C72.2, C73.2, C154.2, C155.2, C156.2, D2.2 (A), J1.3, J1.5, J1.9, J2.1, J3.1, J4.A1 (GND), J4.A12 (GND), J4.B1 (GND), J4.B12 (GND), J5.3, J6.3, J7.3, J10.3, J11.3, J16.2, J17.4, J18.4, J18.5, J18.6, JP1.1 (A), R3.2, R4.2, R6.1, SW1.C, SW1.MP, SW1.S1, U1.2 (GND), U2.10 (VSS), U2.20 (VSSA), U2.23 (PA0), U2.24 (PA1), U2.27 (VSS), U2.29 (PA4), U2.30 (PA5), U2.31 (PA6), U2.32 (PA7), U2.33 (PC4), U2.34 (PC5), U2.35 (PB0), U2.36 (PB1), U2.37 (PB2), U2.43 (PE12), U2.46 (PE15), U2.51 (PB12), U2.52 (PB13), U2.53 (PB14), U2.54 (PB15), U2.57 (PD10), U2.58 (PD11), U2.59 (PD12), U2.63 (PC6), U2.64 (PC7), U2.65 (PC8), U2.66 (PC9), U2.69 (PA10), U2.74 (VSS), U2.77 (PA15), U2.78 (PC10), U2.79 (PC11), U2.80 (PC12), U2.84 (PD3), U2.85 (PD4), U2.86 (PD5), U2.87 (PD6), U2.88 (PD7), U2.90 (PB4), U2.99 (VSS), U3.8 (GND1), U3.9 (GND2), Y1.2, Y1.4
HSE_IN: C16.1, U2.12 (PH0), Y1.1
HSE_OUT: R5.2, U2.13 (PH1)
I2C1_SCL: J2.3, U2.92 (PB6)
I2C1_SDA: J2.4, U2.93 (PB7)
I2C2_SCL: U2.47 (PB10)
I2C2_SDA: U2.48 (PB11)
I2C3_SCL: U2.67 (PA8)
I2C3_SDA: U2.68 (PA9)
JP_BOOT0: JP1.2 (C), R1.1
LED_DATA: U2.45 (PE14)
M0_1: J5.1
M0_2: J5.2
M0_5: J5.5, U3.6 (VIE)
M0_6: J5.6, U3.7 (VIF)
M0_EN1: U2.42 (PE11)
M0_EN2: U2.41 (PE10)
M0_ENCA: U2.25 (PA2), U3.11 (VOE)
M0_ENCB: U2.26 (PA3), U3.10 (VOF)
M0_FAULT: U2.39 (PE8)
M0_IPROPI: U2.38 (PE7)
M0_NSLEEP: U2.40 (PE9)
M1_1: J6.1
M1_2: J6.2
M1_5: J6.5, U3.2 (VIA)
M1_6: J6.6, U3.3 (VIB)
M1_EN1: U2.98 (PE1)
M1_EN2: U2.97 (PE0)
M1_ENCA: U2.15 (PC0), U3.15 (VOA)
M1_ENCB: U2.16 (PC1), U3.14 (VOB)
M1_FAULT: U2.95 (PB8)
M1_IPROPI: U2.91 (PB5)
M1_NSLEEP: U2.96 (PB9)
M2_1: J7.1
M2_2: J7.2
M2_5: J7.5, U3.4 (VIC)
M2_6: J7.6, U3.5 (VID)
M2_EN1: U2.9 (PC15)
M2_EN2: U2.8 (PC14)
M2_ENCA: U2.17 (PC2), U3.13 (VOC)
M2_ENCB: U2.18 (PC3), U3.12 (VOD)
M2_FAULT: U2.5 (PE6)
M2_IPROPI: U2.4 (PE5)
M2_NSLEEP: U2.7 (PC13)
NRST: C12.1, J1.10, U2.14 (NRST)
unnamed: C13.2, U2.49 (VCAP_1)
unnamed: C14.2, U2.73 (VCAP_2)
unnamed: C17.1, R5.1, Y1.3
unnamed: C18.2, R10.1, SW1.S2
unnamed: C19.1, R11.2, SW1.A
unnamed: C20.2, R12.1, SW1.B
unnamed: D1.1 (K), R6.2
unnamed: D1.2 (A), U2.44 (PE13)
unnamed: J4.A5 (CC1), R3.1
unnamed: J4.A6 (D+), J4.B6 (D+), U1.4 (I/O2)
unnamed: J4.A7 (D-), J4.B7 (D-), U1.6 (I/O1)
unnamed: J4.B5 (CC2), R4.1
unnamed: J8.1, J9.1
unnamed: J8.2, J9.2
unnamed: J8.3, J9.3
unnamed: J8.4, J9.4, R7.2
unnamed: J8.5, J9.5
unnamed: J8.6, J9.6
unnamed: R2.1, U2.21 (VREF+)
POWEROFF: U2.1 (PE2)
POWEROFF_REQ: U2.2 (PE3)
ROT_ENC_A: R9.1, R11.1
ROT_ENC_B: R12.2, R13.2
ROT_ENC_SW: R8.1, R10.2
SWCLK: J1.4, U2.76 (PA14)
SWDIO: J1.2, U2.72 (PA13)
SWO: J1.6, U2.89 (PB3)
UART3_RX: J3.2, U2.56 (PD9)
UART3_TX: J3.3, U2.55 (PD8)
USB_D+: U1.3 (I/O2), U2.71 (PA12)
USB_D-: U1.1 (I/O1), U2.70 (PA11)
V+: C33.1, C154.1, C155.1, D65.1 (K), D65.2 (A), D66.1 (K), J10.1, J16.1
VBAT+: C156.1, D66.2 (A), J11.1
VDDA: C9.1, C10.1, FB1.1, R2.2, U2.22 (VDDA)
VUSB+: C15.1, J4.A4 (VBUS), J4.A9 (VBUS), J4.B4 (VBUS), J4.B9 (VBUS), U1.5 (VBUS)

Notes on the sheet:
Filter for the ADC/DAC
C = 2 * (Ccryst_load - Cstray_pcb)
Motor wiring: Pin | Color | Function 1 Red: Motor power 2 Black: Motor power 3 Green: Encoder ground 4 Blue: Encoder Vcc (3.5 V to 20 V) 5 Yellow: Encoder A output 6 White: Encoder B output
SWD connector
Rotary encoder/switch with a debouncing circuit
Oled display pinout: 1: GND 2: VCC 3: SCL 4: SDA
Static discharge USB protection
I2C SSD1306 Display
UART CONNECTOR
Power to the on-board computer
Caps for STM32 supply
CAN HEADER
