Norpz/Baka/robotont-electronics-mainboard-devel-veiko/motor_driver.kicad_sch

## KiCad design robotont-electronics-mainboard-devel-veiko/motor_driver.kicad_sch (2023-09-22)

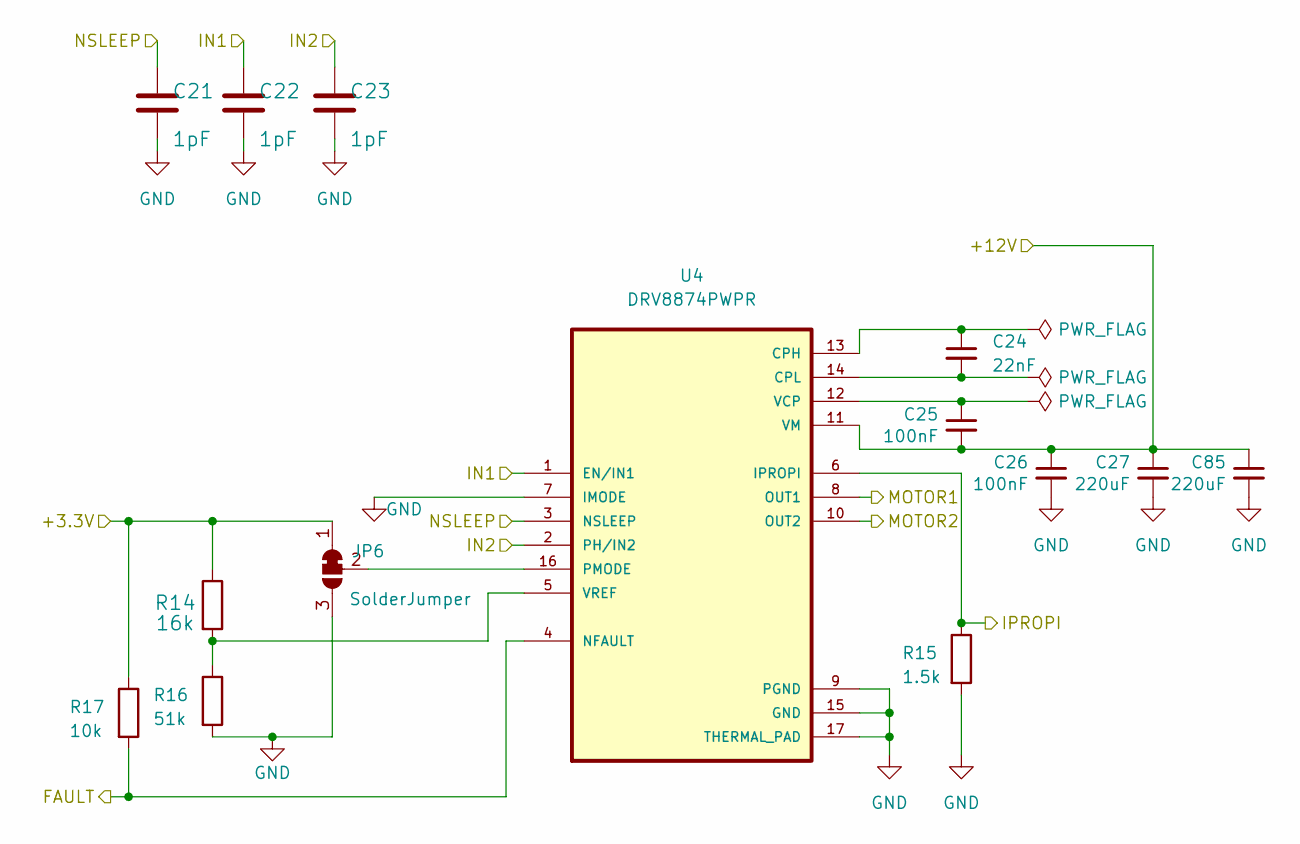
[picture p22: schematic motor_driver.kicad_sch]

Parts:
C21, C22, C23: 1pF; C_0402_1005Metric; LCSC Part C1550
C24: 22nF; C_0603_1608Metric; LCSC Part C21117
C25, C26: 100nF; C_0402_1005Metric; LCSC Part C307331
C27, C85: 220uF; CP_Elec_8x10.5; LCSC Part C251000
JP6: SolderJumper; SolderJumper-3_P1.3mm_Bridged12_Pad1.0x1.5mm
R14: 16k; R_0805_2012Metric; LCSC Part C17490
R15: 1.5k; R_0603_1608Metric; LCSC Part C22843
R16: 51k; R_0603_1608Metric; LCSC Part C23196
R17: 10k; R_0603_1608Metric; LCSC Part C25804
U4: DRV8874PWPR; HTSSOP-16-1EP_4.4x5mm_P0.65mm_EP3.4x5mm_Mask3x3mm_ThermalVi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; LCSC Part C1855818

Connections:
+3.3V: JP6.1 (A), R14.1, R17.1
+12V: C25.2, C26.1, C27.1, C85.1, U4.11 (VM)
FAULT: R17.2, U4.4 (NFAULT)
GND: C21.2, C22.2, C23.2, C26.2, C27.2, C85.2, JP6.3 (B), R15.2, R16.2, U4.7 (IMODE), U4.9 (PGND), U4.15 (GND), U4.17 (THERMAL_PAD)
IN1: C22.1, U4.1 (EN/IN1)
IN2: C23.1, U4.2 (PH/IN2)
IPROPI: R15.1, U4.6 (IPROPI)
MOTOR1: U4.8 (OUT1)
MOTOR2: U4.10 (OUT2)
NSLEEP: C21.1, U4.3 (NSLEEP)
unnamed: C24.1, U4.13 (CPH)
unnamed: C24.2, U4.14 (CPL)
unnamed: C25.1, U4.12 (VCP)
unnamed: JP6.2 (C), U4.16 (PMODE)
unnamed: R14.2, R16.1, U4.5 (VREF)
