Norpz/Baka/robotont-electronics-mainboard-devel-veiko/power_mgmnt.kicad_sch

## KiCad design robotont-electronics-mainboard-devel-veiko/power_mgmnt.kicad_sch (2023-09-22)

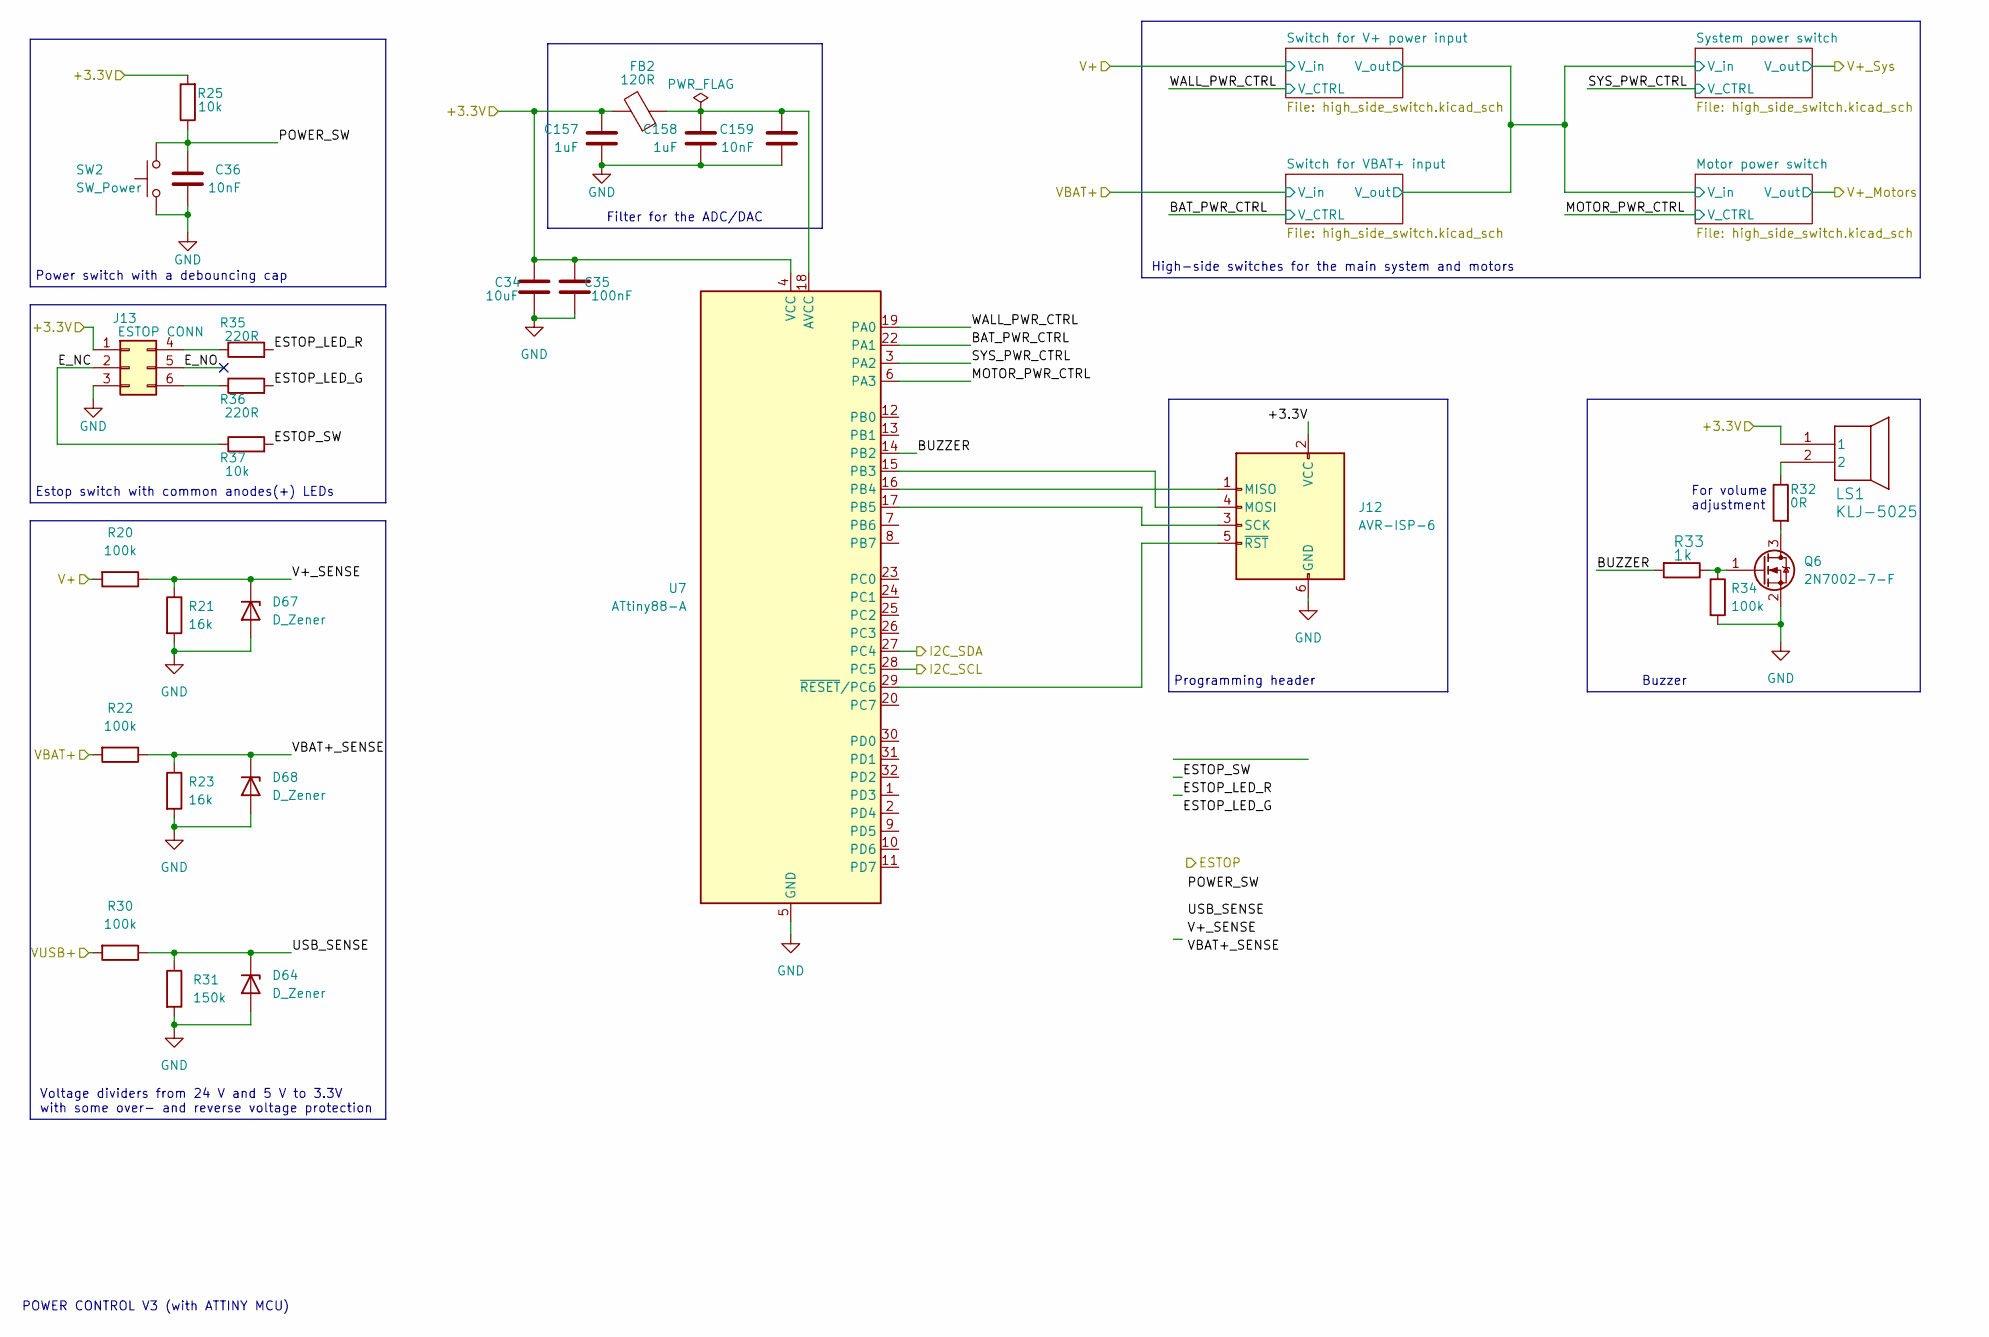
[picture p23: schematic power_mgmnt.kicad_sch]

Parts:
C34: 10uF; C_1206_3216Metric; LCSC Part C13585
C35: 100nF; C_0402_1005Metric; LCSC Part C307331
C36, C159: 10nF; C_0402_1005Metric; LCSC Part C1546
C157, C158: 1uF; C_0603_1608Metric; LCSC Part C15849
D64, D67, D68: D_Zener; D_MiniMELF; LCSC Part C8056
FB2: 120R; R_0805_2012Metric; LCSC Part C1015
J12: AVR-ISP-6; PinHeader_2x03_P2.54mm_Vertical
J13: ESTOP CONN; Molex_Micro-Fit_3.0_43045-0612_2x03_P3.00mm_Vertical
LS1: KLJ-5025; KLJ-5025_KKG; LCSC Part C201046
Q6: 2N7002-7-F; SOT-23; LCSC Part C53550
R20, R22, R30, R34: 100k; R_0603_1608Metric; LCSC Part C25803
R21, R23: 16k; R_0603_1608Metric; LCSC Part C31850
R25, R37: 10k; R_0603_1608Metric; LCSC Part C25804
R31: 150k; R_0603_1608Metric; LCSC Part C22807
R32: 0R; R_0603_1608Metric; LCSC Part C21189
R33: 1k; R_0603_1608Metric; LCSC Part C21190
R35, R36: 220R; R_0603_1608Metric; LCSC Part C22962
SW2: SW_Power; SW_PUSH_6mm_H13mm
U7: ATtiny88-A; TQFP-32_7x7mm_P0.8mm

Connections:
+3.3V: C34.1, C35.2, C157.1, FB2.2, J12.2 (VCC), J13.1, LS1.1, R25.2, U7.4 (VCC)
BAT_PWR_CTRL: U7.22 (PA1)
BUZZER: R33.2, U7.14 (PB2)
ESTOP_LED_G: R36.2
ESTOP_LED_R: R35.2
ESTOP_SW: R37.2
E_NC: J13.2, R37.1
E_NO: J13.5
GND: C34.2, C35.1, C36.2, C157.2, C158.2, C159.2, D64.2 (A), D67.2 (A), D68.2 (A), J12.6 (GND), J13.3, Q6.2 (S), R21.2, R23.2, R31.2, R34.2, SW2.1, U7.5 (GND), U7.21 (GND)
I2C_SCL: U7.28 (PC5)
I2C_SDA: U7.27 (PC4)
MOTOR_PWR_CTRL: U7.6 (PA3)
unnamed: C158.1, C159.1, FB2.1, U7.18 (AVCC)
unnamed: J12.1 (MISO), U7.16 (PB4)
unnamed: J12.3 (SCK), U7.17 (PB5)
unnamed: J12.4 (MOSI), U7.15 (PB3)
unnamed: J12.5 (~RST), U7.29 (~RESET/PC6)
unnamed: J13.4, R35.1
unnamed: J13.6, R36.1
unnamed: LS1.2, R32.1
unnamed: Q6.1 (G), R33.1, R34.1
unnamed: Q6.3 (D), R32.2
POWER_SW: C36.1, R25.1, SW2.2
SYS_PWR_CTRL: U7.3 (PA2)
USB_SENSE: D64.1 (K), R30.1, R31.1
V+: R20.2
V+_SENSE: D67.1 (K), R20.1, R21.1
VBAT+: R22.2
VBAT+_SENSE: D68.1 (K), R22.1, R23.1
VUSB+: R30.2
WALL_PWR_CTRL: U7.19 (PA0)

Notes on the sheet:
For volume adjustment
POWER CONTROL V3 (with ATTINY MCU)
Voltage dividers from 24 V and 5 V to 3.3V with some over- and reverse voltage protection
Power switch with a debouncing cap
High-side switches for the main system and motors
Programming header
Filter for the ADC/DAC
Estop switch with common anodes(+) LEDs
Buzzer
