Norpz/Baka/robotont-electronics-mainboard-devel-veiko/powerpathctl.kicad_sch

## KiCad design robotont-electronics-mainboard-devel-veiko/powerpathctl.kicad_sch (2023-09-22)

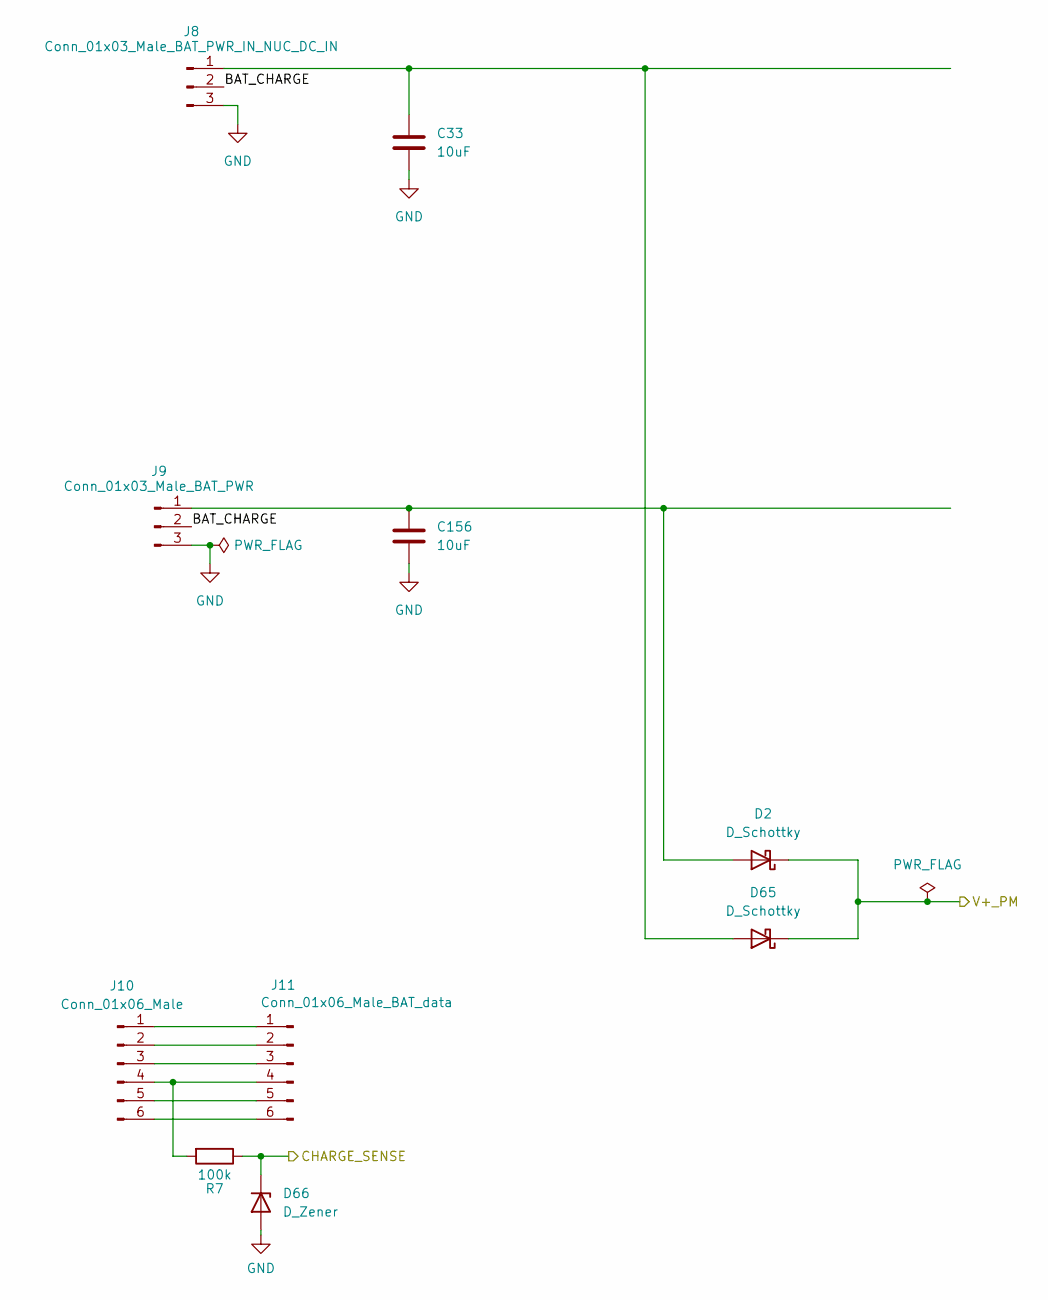
[picture p24: schematic powerpathctl.kicad_sch]

Parts:
C33, C156: 10uF; C_1206_3216Metric; LCSC Part C13585
D2, D65: D_Schottky; D_SMA; LCSC Part C92506
D66: D_Zener; D_MiniMELF; LCSC Part C8056
J8: Conn_01x03_Male_BAT_PWR_IN_NUC_DC_IN; AMASS_MR30PW-M_1x03_P3.50mm_Horizontal
J9: Conn_01x03_Male_BAT_PWR; AMASS_MR30PW-M_1x03_P3.50mm_Horizontal
J10: Conn_01x06_Male; JST_PH_S6B-PH-K_1x06_P2.00mm_Horizontal
J11: Conn_01x06_Male_BAT_data; JST_PH_S6B-PH-K_1x06_P2.00mm_Horizontal
R7: 100k; R_0603_1608Metric; LCSC Part C25803

Connections:
BAT_CHARGE: J8.2, J9.2
CHARGE_SENSE: D66.1 (K), R7.1
GND: C33.2, C156.2, D66.2 (A), J8.3, J9.3
unnamed: C33.1, D65.2 (A), J8.1
unnamed: C156.1, D2.2 (A), J9.1
unnamed: J10.1, J11.1
unnamed: J10.2, J11.2
unnamed: J10.3, J11.3
unnamed: J10.4, J11.4, R7.2
unnamed: J10.5, J11.5
unnamed: J10.6, J11.6
V+_PM: D2.1 (K), D65.1 (K)
